gchenfc/DEV_FCcontroller/Controller_v2.1.0/readme.txt

This is the code to be uploaded to the Teensy in Duke Electric Vehicle’s H2 Fuel Cell controller and voltage converter.
This code is the final version used in the 2018 Eco-Marathon, but it still has lots of quirks and bugs.
