gchenfc/DEV_FCcontroller/EagleBoard/H2_v2/bottom.png

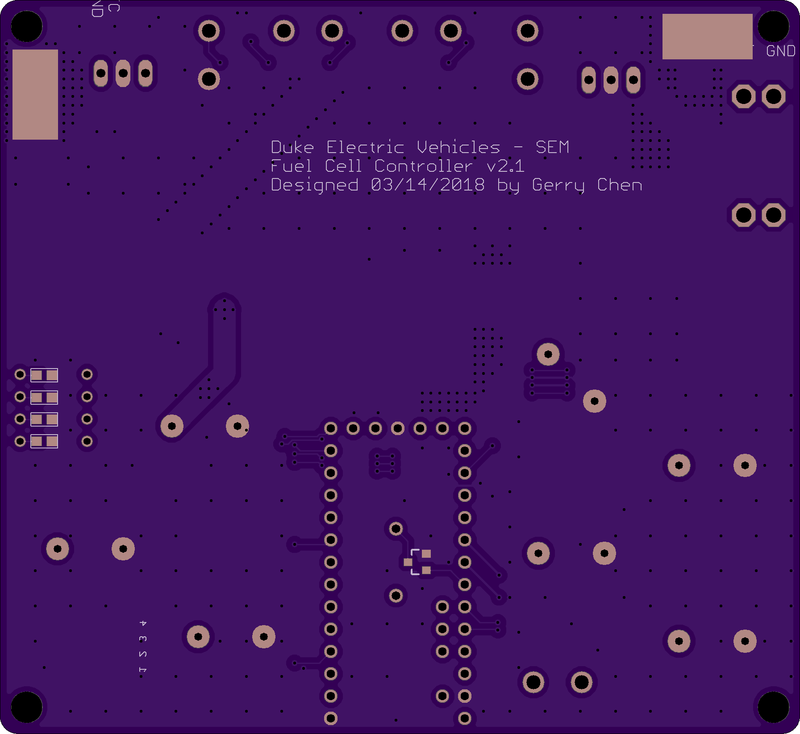
EagleBoard/H2_v2/bottom.png
