gchenfc/DEV_FCcontroller/EagleBoard/H2_v2/top.png

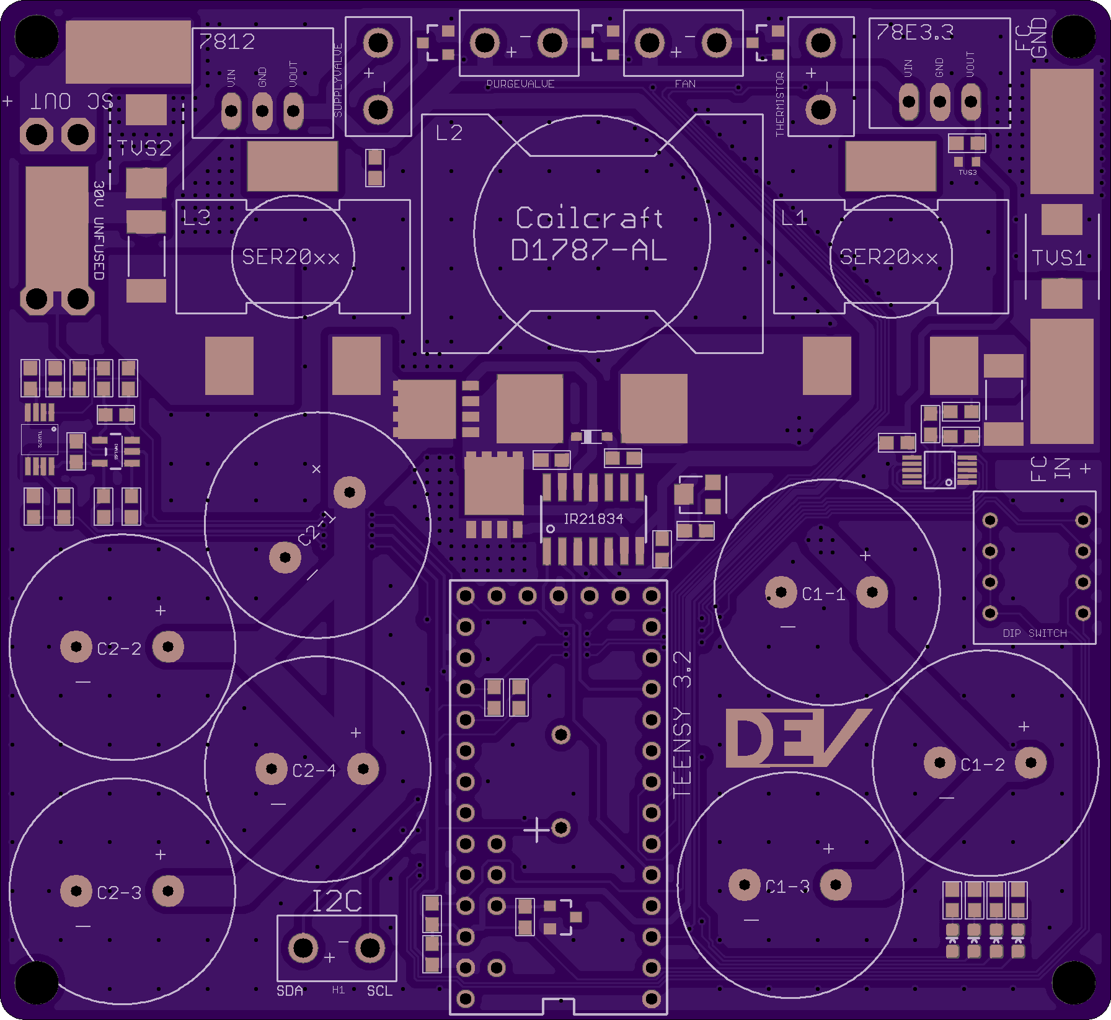
EagleBoard/H2_v2/top.png
