gchenfc/DEV_FCcontroller/EagleBoard/main.brd

## EAGLE design EagleBoard/main.brd (2018-04-25)

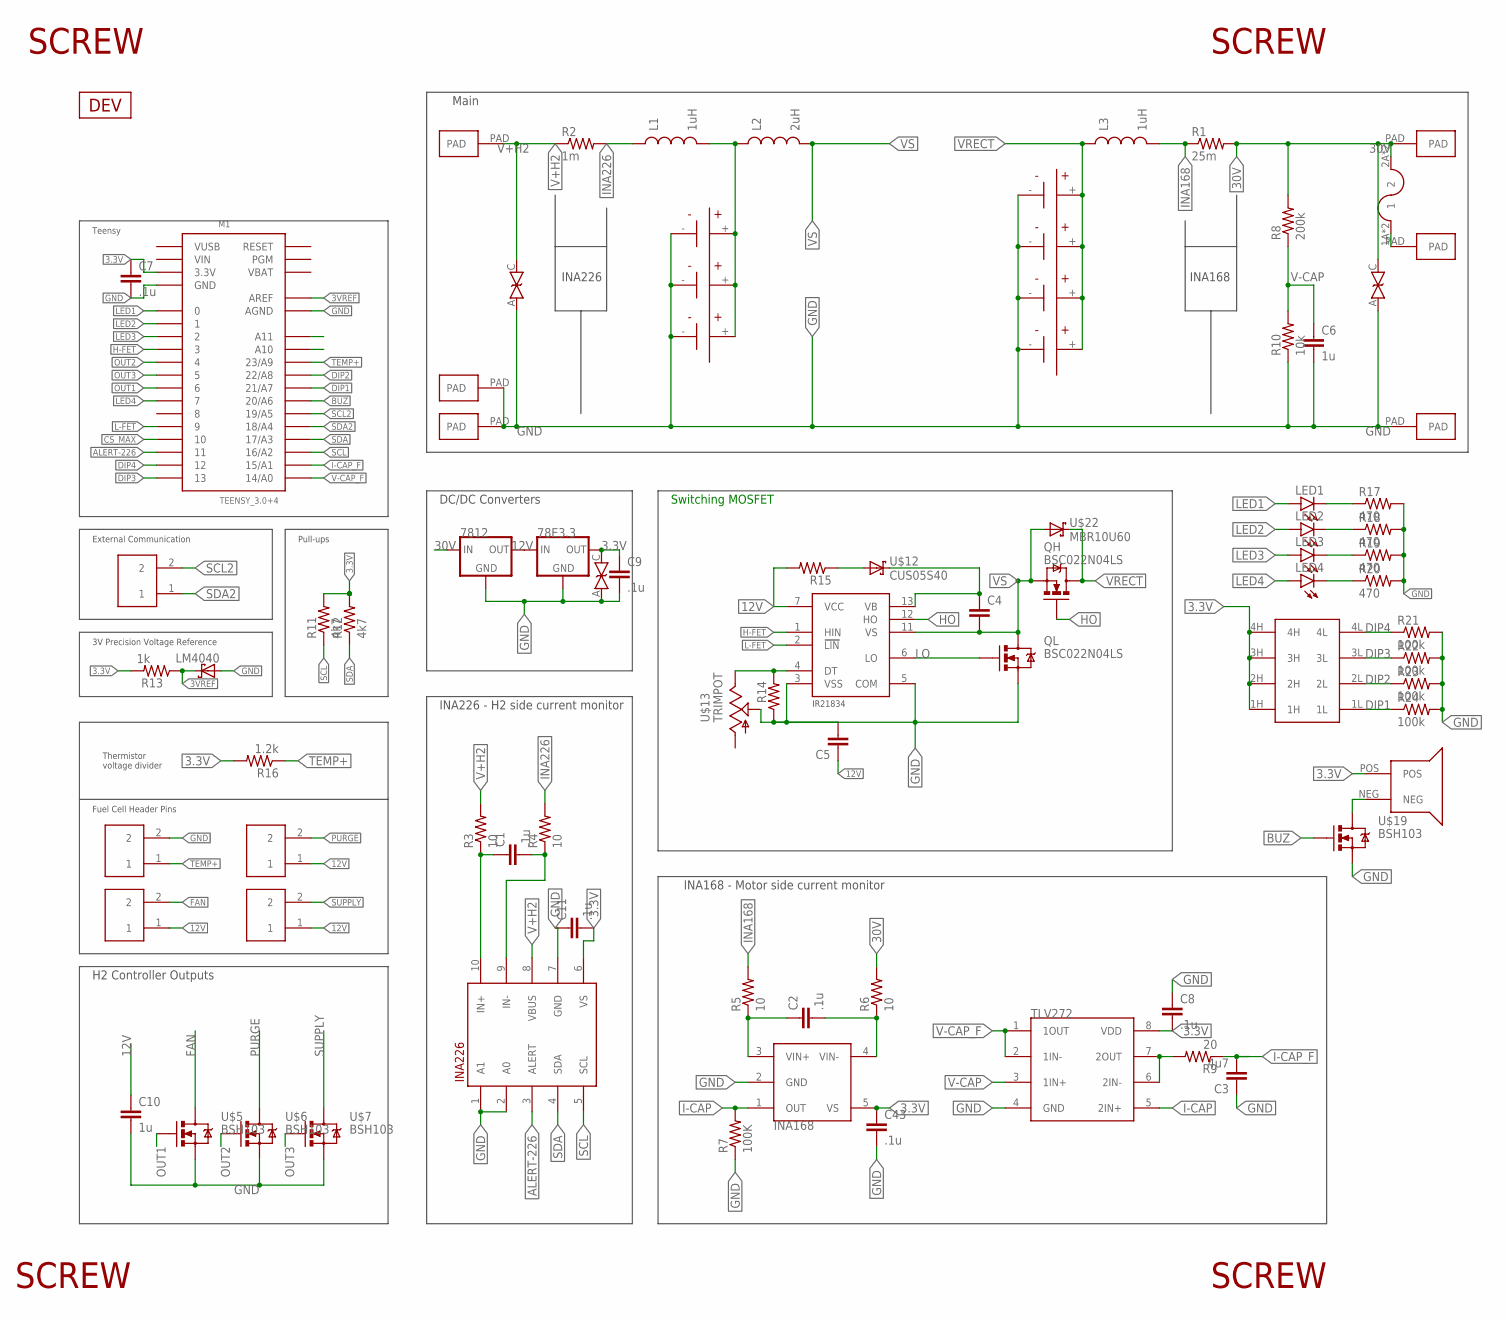
[picture p3: schematic main.sch]

Parts:
78E3.3: V_REG_78XXR-78E; V78W
7812: V_REG_78XXV78W; V78W
C1, C2, C7, C8, C9, C11, C43: .1u; 0603-CAP
C1-1, C1-2, C1-3, C2-1, C2-2, C2-3, C2-4: 2400u; CAP-RADIAL
C3: 4u7; 0603-CAP
C4, C5: CAP0603-CAP; 0603-CAP
C6, C10: 1u; 0603-CAP
FAN: HEADER2; 2PINVALULOK
H1: HEADER2; 2PINVALULOK
L1, L3: 1uH; SER20XX
L2: 2uH; D1787
LED1, LED2, LED3, LED4: LED0603; LED-0603
M1: TEENSY_3.0+4
PURGEVALVE: HEADER2; 2PINVALULOK
QH: BSC022N04LS; PG-TDSON-8
QL: BSC022N04LS; PG-TDSON-8
R1: 25m; R2512
R2: 1m; R2512
R3, R4, R5, R6: 10; 0603-RES
R7: 100K; 0603-RES
R8: 200k; 0603-RES
R9: 20; 0603-RES
R10: 10k; 0603-RES
R11, R12: 4k7; 0603-RES
R13: 1k; 0603-RES
R14, R15: RESISTOR0603-RES; 0603-RES
R16: 1.2k; 0603-RES
R17, R18, R19, R20: 470; 0603-RES
R21, R22, R23, R24: 100k; 0603-RES
SUPPLYVALVE: HEADER2; 2PINVALULOK
THERMISTOR: HEADER2; 2PINVALULOK
TVS1: 15V; DO-214AB
TVS2: 60V; DO-214AB
TVS3: 3.3V; SOD-523
U1: INA226; PSOP-10
U2: INA168INA168; SOT23-5
U3: TLV272; 8-VSSOP
U$1, U$2, U$3, U$4, U$10, U$16: PAD
U$5, U$6, U$7, U$19: BSH103; SOT23-3
U$8, U$11, U$17, U$29: SCREW; M3HOLE
U$9: IR21834; SO14
U$12: CUS05S40; SOD323_ST
U$13: TRIMPOT; 3MM_TRIMM
U$14: LM4040; SOT23-3
U$15: FUSE; AUTO_FUSE
U$18: BUZZER12MM; BUZZER_12MM
U$20: DIP_SWITCH; DIPSWITCH4
U$21: DEV
U$22: MBR10U60; TO-277

Connections:
3.3V: 78E3.3.OUT, C7.1, C8.2, C9.1, C11.2, C43.1, M1.3.3V, M1.3.3V1 (3.3V), R11.2, R12.2, R13.2, R16.2, TVS3.C (2), U1.6 (VS), U2.5 (VS), U3.8 (VDD), U$18.POS, U$20.1H, U$20.2H, U$20.3H, U$20.4H
3VREF: M1.AREF, R13.1, U$14.1 (C)
12V: 78E3.3.IN, 7812.OUT, C5.1, C10.1, FAN.1, PURGEVALVE.1, R15.2, SUPPLYVALVE.1, U$9.7 (VCC)
30V: 7812.IN, R1.2, R6.2, R8.2, TVS2.C (2), U$1.PAD, U$15.2A (2), U$15.2B (2)
30VFUSED: U$15.1A (1), U$15.1B (1), U$16.PAD
ALERT-226: M1.11, U1.3 (ALERT)
BUZ: M1.20/A6, U$19.1 (G)
CS_MAX: M1.10
DIP1: M1.21/A7, R24.1, U$20.1L
DIP2: M1.22/A8, R23.1, U$20.2L
DIP3: M1.13, R22.1, U$20.3L
DIP4: M1.12, R21.1, U$20.4L
DT: R14.2, U$9.4 (DT), U$13.3 (E)
FAN: FAN.2, U$5.3 (D)
GND: 78E3.3.GND, 7812.GND, C1-1.- (V-), C1-2.- (V-), C1-3.- (V-), C2-1.- (V-), C2-2.- (V-), C2-3.- (V-), C2-4.- (V-), C3.1, C5.2, C6.2, C7.2, C8.1, C9.2, C10.2, C11.1, C43.2, M1.AGND, M1.GND, M1.GND1 (GND), QL.1 (S), QL.2 (S), QL.3 (S), R7.1, R10.1, R14.1, R17.2, R18.2, R19.2, R20.2, R21.2, R22.2, R23.2, R24.2, THERMISTOR.2, TVS1.A (1), TVS2.A (1), TVS3.A (1), U1.1 (A1), U1.2 (A0), U1.7 (GND), U2.2 (GND), U3.4 (GND), U$2.PAD, U$4.PAD, U$5.2 (S), U$6.2 (S), U$7.2 (S), U$9.3 (VSS), U$9.5 (COM), U$10.PAD, U$13.2 (S), U$14.2 (A), U$19.2 (S)
H-FET: M1.3, U$9.1 (HIN)
HO: QH.4 (G), U$9.12 (HO)
I-CAP: R7.2, U2.1 (OUT), U3.5 (2IN+)
I-CAP_F: C3.2, M1.15/A1, R9.1
INA168: L3.1 (0), R1.1, R5.2
INA226: L1.2 (1), R2.2, R4.2
L-FET: M1.9, U$9.2 (LIN)
LED1: LED1.A, M1.0
LED2: LED2.A, M1.1
LED3: LED3.A, M1.2
LED4: LED4.A, M1.7
LO: QL.4 (G), U$9.6 (LO)
unnamed: C1.1, R3.1, U1.10 (IN+)
unnamed: C2.1, R5.1, U2.3 (VIN+)
unnamed: C1.2, R4.1, U1.9 (IN-)
unnamed: C2.2, R6.1, U2.4 (VIN-)
unnamed: R15.1, U$12.A
unnamed: C1-1.+ (V+), C1-2.+ (V+), C1-3.+ (V+), L1.1 (0), L2.P$2 (1)
unnamed: LED1.C, R17.1
unnamed: LED2.C, R18.1
unnamed: R9.2, U3.6 (2IN-), U3.7 (2OUT)
unnamed: LED3.C, R19.1
unnamed: LED4.C, R20.1
unnamed: U$18.NEG, U$19.3 (D)
OUT1: M1.6, U$5.1 (G)
OUT2: M1.4, U$6.1 (G)
OUT3: M1.5, U$7.1 (G)
PURGE: PURGEVALVE.2, U$6.3 (D)
SCL: M1.16/A2, R11.1, U1.5 (SCL)
SCL2: H1.2, M1.19/A5
SDA: M1.17/A3, R12.1, U1.4 (SDA)
SDA2: H1.1, M1.18/A4
SUPPLY: SUPPLYVALVE.2, U$7.3 (D)
TEMP+: M1.23/A9, R16.1, THERMISTOR.1
V+H2: R2.1, R3.2, TVS1.C (2), U1.8 (VBUS), U$3.PAD
V-CAP: C6.1, R8.1, R10.2, U3.3 (1IN+)
V-CAP_F: M1.14/A0, U3.1 (1OUT), U3.2 (1IN-)
VB: C4.1, U$9.13 (VB), U$12.C
VBAT: M1.VBAT
VIN: M1.VIN
VRECT: C2-1.+ (V+), C2-2.+ (V+), C2-3.+ (V+), C2-4.+ (V+), L3.2 (1), QH.5 (D), QH.6 (D), QH.7 (D), QH.8 (D), QH.TH (D), U$22.3 (C)
VS: C4.2, L2.P$1 (0), QH.1 (S), QH.2 (S), QH.3 (S), QL.5 (D), QL.6 (D), QL.7 (D), QL.8 (D), QL.TH (D), U$9.11 (VS), U$22.1 (A), U$22.2 (A)
VUSB: M1.VUSB

Notes on the sheet:
INA226
INA168
INA226 - H2 side current monitor
INA168 - Motor side current monitor
Main
Switching MOSFET
H2 Controller Outputs
DC/DC Converters
Teensy
Fuel Cell Header Pins
Thermistor voltage divider
Pull-ups
External Communication
3V Precision Voltage Reference

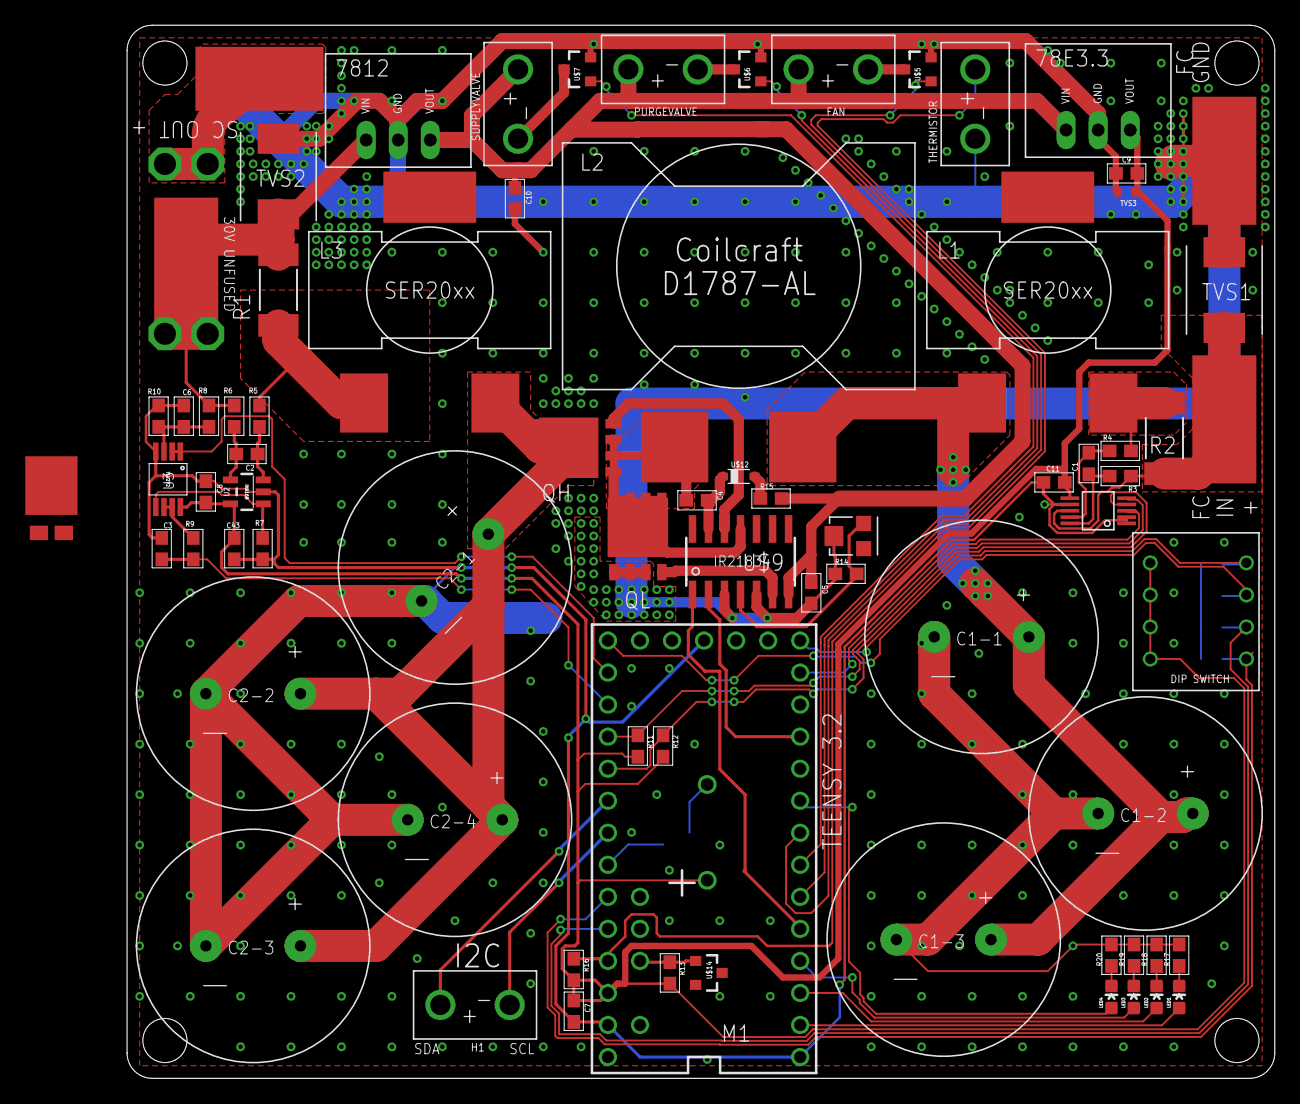
[picture p4: board main.brd from above]

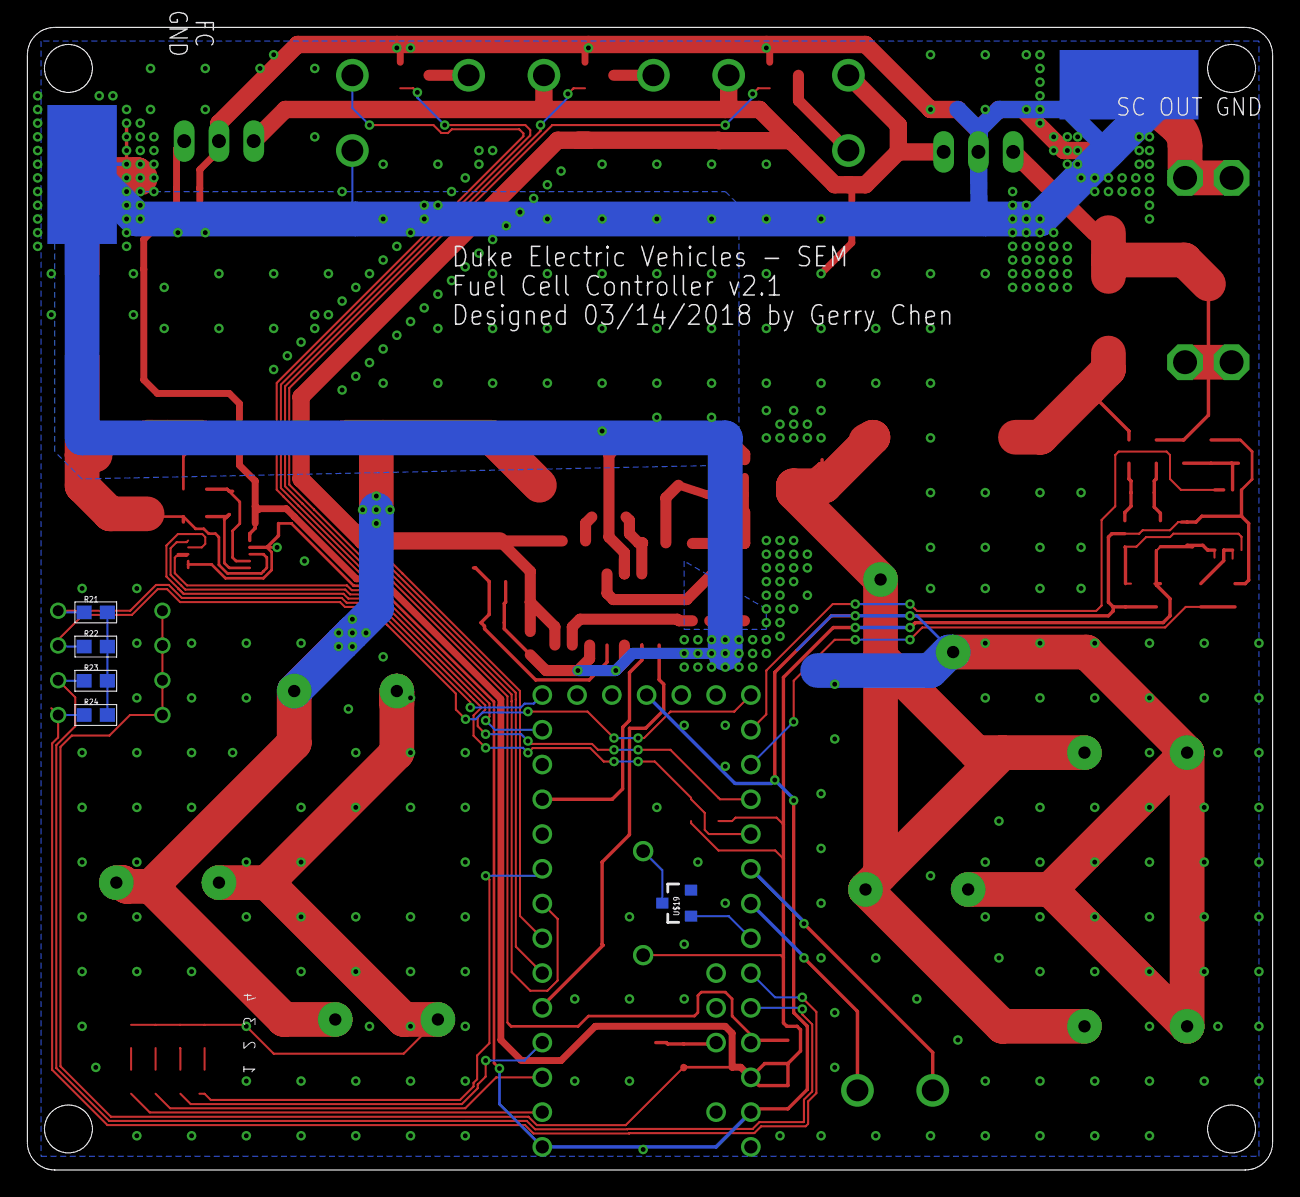
[picture p5: board main.brd from below]

Board: 2 copper layers, 91.0 x 83.5 mm, 89 parts (7 on the bottom side), 54 nets.
