gchenfc/DEV_FCcontroller/Controller_v2.1.0/PinAssignments.h

#ifndef PinAssignments_h
#define PinAssignments_h

#define RSHUNT_FC 0.002
#define RSHUNT_SC 0.0125

#define LFETold 9
#define LFET 4  // don't change this - it's set to FTM1C1
#define HFET 3  // don't change this - it's set to FTM1C0
#define STABLE12V A10

#define SCL1 16
#define SDA1 17
#define ICAP A1
#define VCAP A0

#define FAN 6
#define PURGE 10
#define SUPPLY 5
#define TEMP A9

#define LED1 0
#define LED2 1
#define LED3 2
#define LED4 7

#define DIP1 21
#define DIP2 22
#define DIP3 13
#define DIP4 12

#define BUZZ 20

#endif
