gchenfc/DEV_FCcontroller/(commit log)

2018-02-18 PID working for power stabilization
2018-03-02 PID Library by Alex Beattie
2018-04-05 New controller code for board v2.1 Almost final version - properly regulates power, fuel cell, and monitors supercaps. Still need to test i2c communication with BMS, but should be pretty close to wor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
    [Communication.h, Constants.h, Controller.cpp, Controller.h, Converter.cpp, Converter.h, MASTER_CONTROLLER.ino, PinAssignments.h]
2018-04-25 FINAL SEM 2018 CODE
    [main.brd, main.sch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]
2018-05-29 Alicat-Teensy code example
